gustavoriverag/thorkellbot/src/docs/ThorkellBOM.xlsx

Subassembly | Part Name | Part number | Qty | Manufactured? | Material | Manufacturing Process | Commercial Reference
Transmission and Structure | Chassis | TB001 | 1 | Yes | Aluminum Composite Panel | CNC routing | N.A.
Transmission and Structure | Motor | TB002 | 2 | No | Steel | N.A | JGY-370 210 RPM
Transmission and Structure | Motor Bracket | TB003 | 2 | No | Steel | N.A | N.A.
Mould | Mould Half 1 | TB004 | 1 | Yes | PLA | 3D Printing | N.A.
Mould | Mould Half 2 | TB005 | 1 | Yes | PLA | 3D Printing | N.A.
Wheels | Wheel | TB006 | 2 | Yes | PLA | 3D Printing | N.A.
Wheels | Hex Coupling | TB007 | 2 | No | Brass | N.A | https://es.aliexpress.com/item/1005004661320406.html?curPageLogUid=9bkiHc8fLoRG
Wheels | Tire | TB008 | 2 | Yes | Silicone Rubber | Casting | N.A.
Bodykit | Weapon | TB009 | 1 | Yes | PLA | 3D Printing
Bodykit | Wall | TB010 | 2 | Yes | PLA | 3D Printing
Bodykit | Arduino Support | TB011 | 1 | Yes | PLA | 3D Printing
Bodykit | Protoboard Support | TB012 | 1 | Yes | PLA | 3D Printing
Electronics | Battery | TB013 | 1 | No | LiPo | N.A | 11.1 V, Helps maintain weight under 1kg.
Electronics | Arduino UNO | TB014 | 1 | No | N.A | N.A | https://docs.arduino.cc/hardware/uno-rev3
Electronics | Motor H Bridge | TB015 | 1 | No | N.A | N.A | Model L298N or similar
Electronics | Ultrasonic Sensor | TB016 | 1 | No | N.A | N.A | HC-SR04
Electronics | Obstacle Avoidance Sensor | TB017 | 1 | No | N.A | N.A | TCRT5000 Module
Electronics | Dupont Cables | TB018 | 13 | No | N.A | N.A | Male to Female
Electronics | Dupont Cables | TB019 | 5 | No | N.A | N.A | Male to Male
Electronics | Copper Cables | TB020 | 1 | No | N.A | N.A | <22awg, for soldering motors, switch
Electronics | Battery Connector | TB021 | 1 | No | N.A | N.A | Depends on battery model
Fixture | M4 Bolt | TB022 | 4 | No | N.A | N.A | 8mm long
Fixture | M4 Nut | TB023 | 4 | No | N.A | N.A
Fixture | M3 Bolt | TB024 | 7 | No | N.A | N.A | Flat head, 16mm long
Fixture | M3 Bolt | TB025 | 15 | No | N.A | N.A | Flat head, 10mm long
Fixture | M3 Nut | TB026 | 7 | No | N.A | N.A
Fixture | 2mm screw | TB027 | 4 | No | N.A | N.A
